emincinalioglu/Ankara-Instruments/test result/_85 duty cycle rl load.jpg

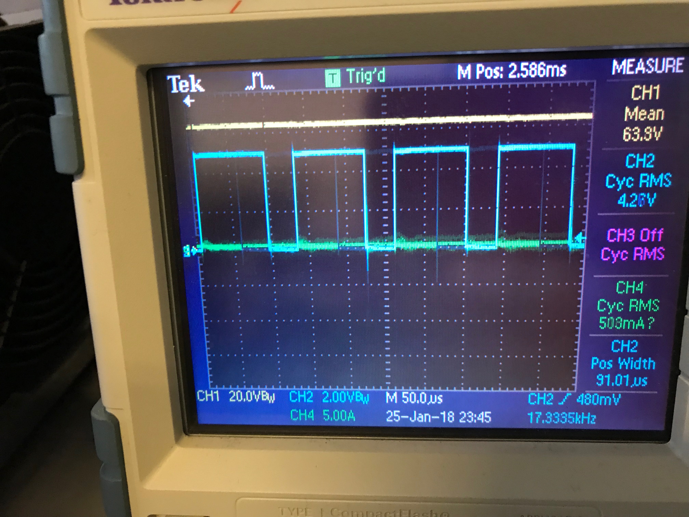
test result/_85 duty cycle rl load.jpg
