emincinalioglu/Ankara-Instruments/test result/_15 duty cycle r load.jpg

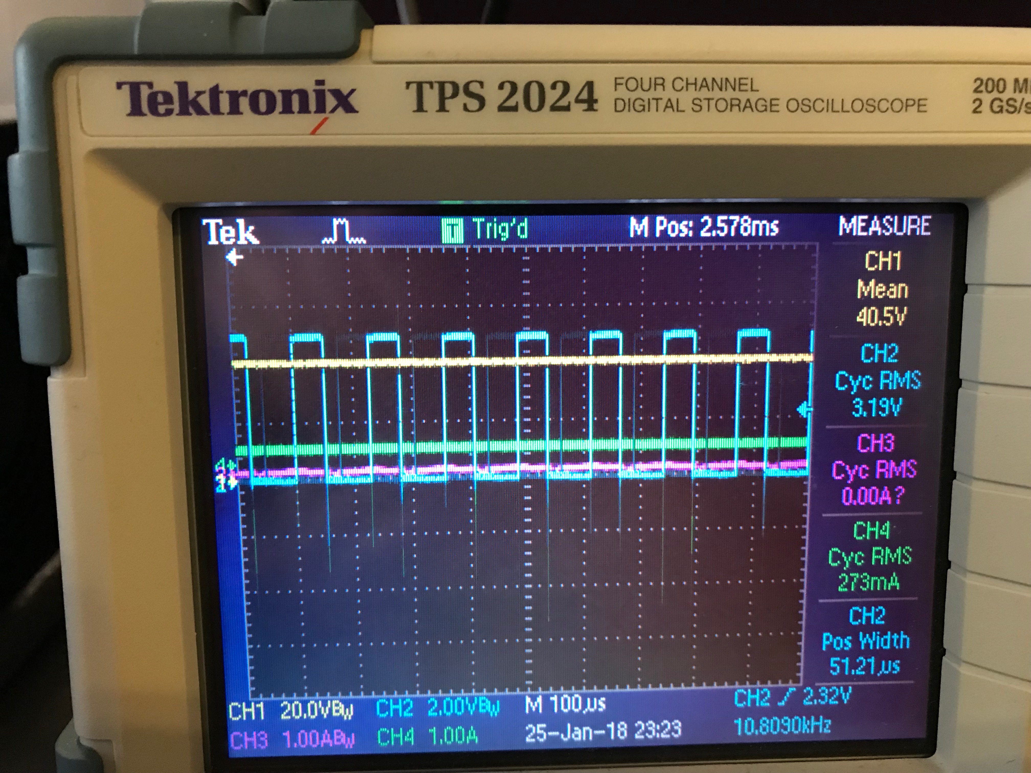
test result/_15 duty cycle r load.jpg
