emincinalioglu/Ankara-Instruments/README.md

# Ankara-Instruments

https://drive.google.com/open?id=17f6EGrr7mS8Uh7WiCu8BmIiLnXTHfP1c
