emincinalioglu/Ankara-Instruments/inductor calculation.docx

İnductor turn ratio calculation

L=(dλ)/(di)=N(dΦ)/(di)

Φ=BA

Φ=F/R

R=l/(μA)

L=N/R(dF)/(di)=(N^2)/R(di)/(di)

L=(N^2 Aμ)/l

We need 1mH;

From the datasheet

Effective magnetic path length (l) =145mm

Effective cross-section area(A) = 158 mm^2

Relative permeability (μr) = 2000

N=√((L*l)/(A*μ))=√((1.3*10^(-3) *0.145)/(158*10^(-6) *2000*4π*10^(-7)))=22 turns
