emincinalioglu/Ankara-Instruments/test result/_15 duty cycle rl load.jpg

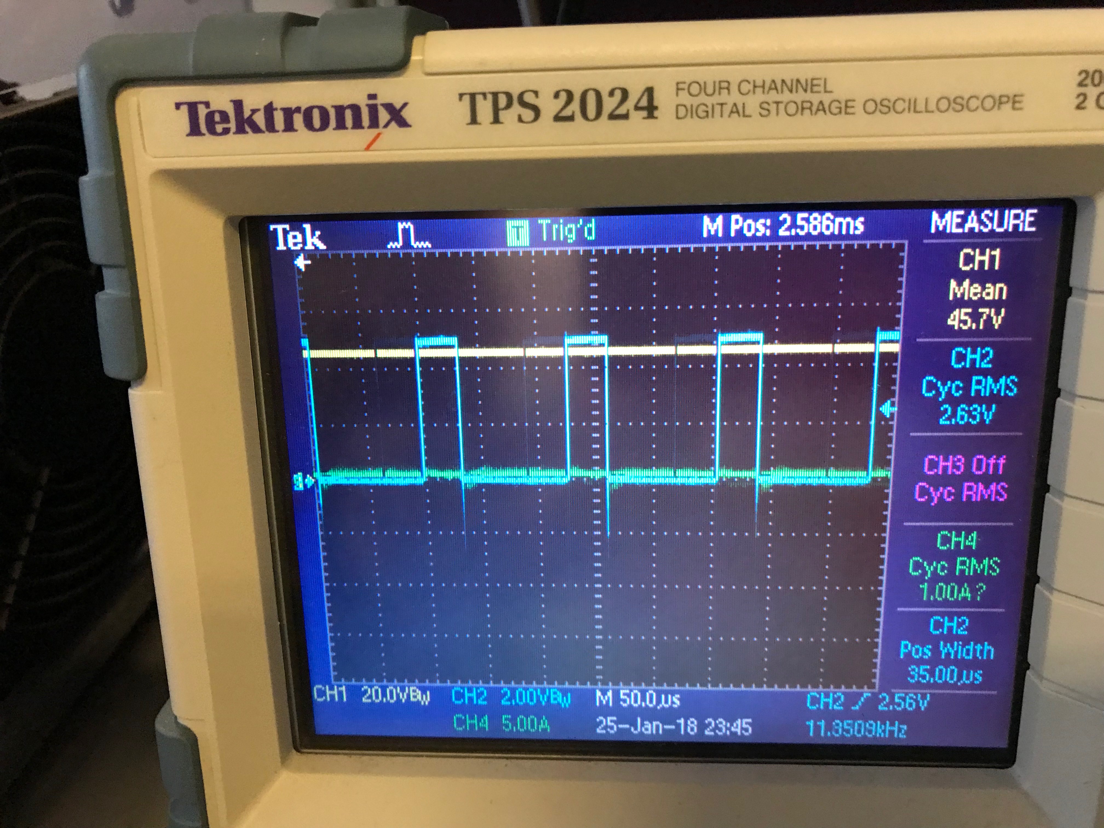
test result/_15 duty cycle rl load.jpg
