emincinalioglu/Ankara-Instruments/test result/_50 duty cycle r load.jpg

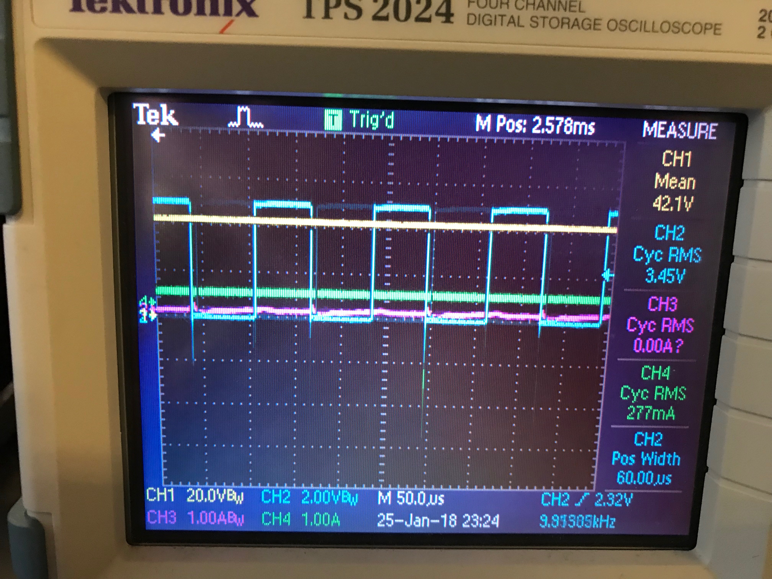
test result/_50 duty cycle r load.jpg
