emincinalioglu/Ankara-Instruments/test result/_50 duty cycle rl load.jpg

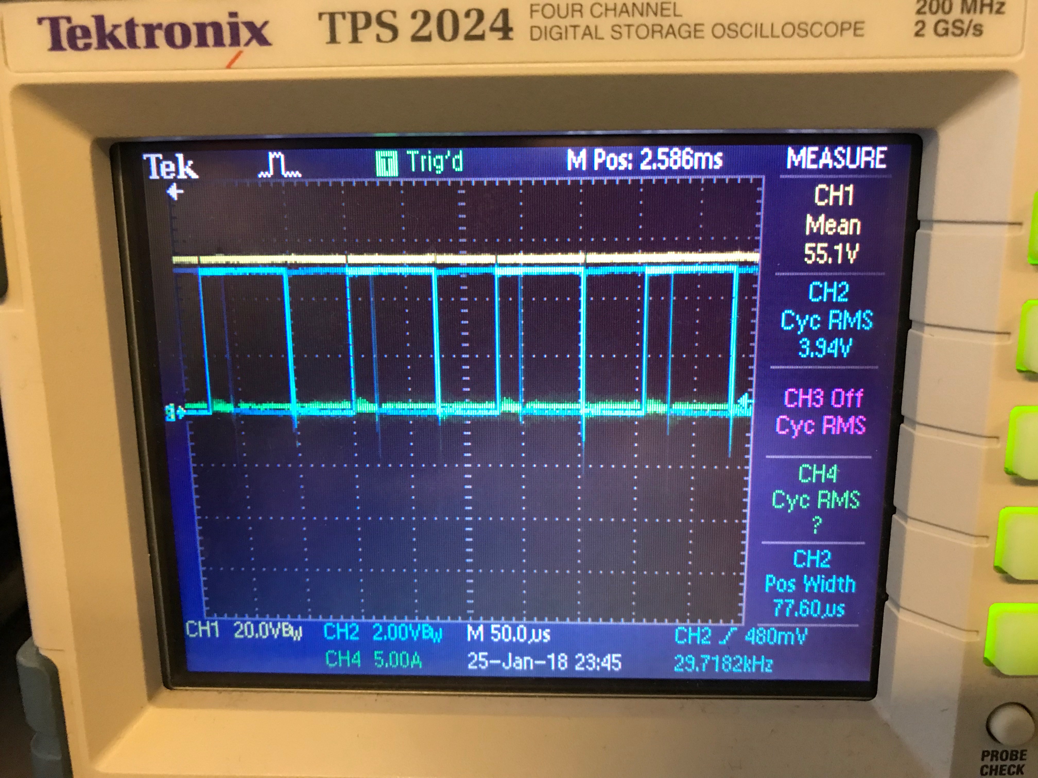
test result/_50 duty cycle rl load.jpg
