emincinalioglu/Ankara-Instruments/test result/_85 duty cycle r load.jpg

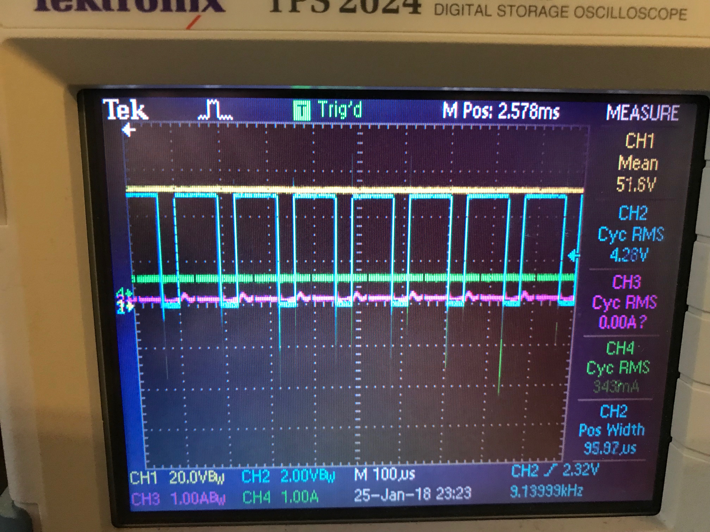
test result/_85 duty cycle r load.jpg
