emincinalioglu/Ankara-Instruments/(commit log)

2018-01-01 Selected Topology Sİmulation
    Diode Rectifier+Buck converter topolojisinin Simulink modellemesi yapıldı. Bazı eksiklikleri var, tamamlanması gerekiyor. Diode rectifier'ın hemen çıkışında akım çok yüksek bir değere çıkıyor, sebebini henüz bulamadım.
2018-01-26 Arduino_PWM
    Added Arduino PWM code, reference to borrowed code provided
2018-01-28 DC motor specs
    DC motor specs added
